ORNL/uCaspian/ip/osresearch/README.md

osresearch
==========

This HDL was originally sourced from [osresearch/up5k](https://github.com/osresearch/up5k) and modified.

divide_by_n.v: https://github.com/osresearch/up5k/blob/2eef12a9659b8fc4ebf68656198b8840f6da2e0d/util.v
pulse_stretcher.v: https://github.com/osresearch/up5k/blob/2eef12a9659b8fc4ebf68656198b8840f6da2e0d/util.v
pwm.v: https://github.com/osresearch/up5k/blob/2eef12a9659b8fc4ebf68656198b8840f6da2e0d/util.v
util.vh: https://github.com/osresearch/up5k/blob/2eef12a9659b8fc4ebf68656198b8840f6da2e0d/util.v
uart.v: https://github.com/osresearch/up5k/blob/2eef12a9659b8fc4ebf68656198b8840f6da2e0d/uart.v
