ORNL/uCaspian/CHANGELOG.md

# Changelog

All notable changes to this project will be documented in this file.

The format is based on [Keep a Changelog](https://keepachangelog.com/en/1.0.0/),
and this project adheres to a custom Development Versioning specified by Aaron Young.

A summary of Development Versioning Specification is shown below.

> Given a version number BRANCH.TAG.BUILD, increment the:
> 1. BRANCH version when you make breaking/major changes that you want to track in a separate branch.
> 2. TAG version when you make a new tag to mark a specific spot.
> 3. BUILD version when you create a new build with artifacts or bug fixes for that you want to point to.
>
> Then for your repo you have branch versions for each version. For example branches v0 and v1. Then when you create tags, say on branch v0, you would create tags v0.0.0, v0.1.0, and v0.2.0.
> CI or a manual process could add v0.0.x branches as new changes are added to a local branch. BUILD is also used when patches are applied to a tagged branch, after the patch is applied, add a new tag with BUILD + 1.
>
> `main` always points to the current major branch plus 1. `dev` is an integration branch before merging into `main`. When `dev` is merged into `main`, the TAG is updated.

## [2.0.0] - 2023-09-14

### Changed
- Restructured project to better support using uCaspian in an external project.
- Separated third party IP from ORNL uCaspian RTL.
- Updated and attempted to improve README.

### Added
- Sphinx documentation generator.
- Basic SystemVerilog testbench.
- Conda environment.
- Low power uduinolp/ucaspianlp designs with clock gating.
- Wishbone interface wrapper and testbench.
- Lint waivers.

### Removed
- Unused network files.
- Support for mimas board.

## [1.0.0] - 2023-09-09

Released an initial version of uCaspian from Parker Mitchell. This version has no breaking or major
changes from the original uCaspian source.

### Added
- Initial Code from Parker.
- A changelog.
