ORNL/uCaspian/(commit log)

2019-12-04 possible for fix output spike issues
    [ucaspian_core.sv]
2019-12-12 fix what seems to be a dendrite accumulation bug when two inputs target same idx back to back
    [dendrite.sv, neuron.sv]
2020-03-06 project set up for dev board
2020-03-16 redesign neuron, fix dendrite/neuron handshake, misc cleanup
    [dendrite.sv, dendrite_mux.sv, dev_r0.pcf, dp_ram.sv, neuron.sv]
2020-04-27 clear activity for delay; fix axon 0 special case
    [axon.sv]
2020-04-27 (axon) fix double fire & stuck fire
    [axon.sv]
2020-04-27 going to bed
2020-04-28 [axonal delay] very chicken wired, but closer?
2020-04-29 reset & clear bug fixes
    [axon.sv, dendrite.sv, dendrite_mux.sv, neuron.sv, ucaspian_core.sv]
2020-05-03 fix write after write data dependency in dendrite
    [dendrite.sv]
2020-05-07 try to fix blocking on sequential axon fires
    [axon.sv]
2020-05-11 fix saturating addition of charge in neuron
    [neuron.sv]
2020-05-11 makes the fix work properly on fpga, not just verilator
    [neuron.sv]
2020-05-11 fix flow control in fire dispatch
    [fire_dispatch.sv]
2020-05-15 A redesign of the axon
    [axon.sv]
2020-05-15 attempt to patch multi-fire bug in neuron when paired with new axon
    [neuron.sv]
2020-05-16 more attempts to fix a2a+dly tests
    [axon.sv, neuron.sv]
2020-05-17 event driven axon, synapse/dendrite speed up and fixes
    [axon.sv, dendrite_mux.sv, fire_dispatch.sv, synapse.sv]
2020-05-18 neuron flow control fix?
    [neuron.sv]
2020-05-18 is this better? tests say maybe but there are still problems with a2a + dly networks
    [axon.sv]
2020-05-18 the final fix -- now passing the initial a2a+dly tests
    [axon.sv, find_set_bit.sv]
2020-05-19 bump up the communications -- should work but there were problems the last time I did this
    [dev_r0_top.sv]
2020-05-29 make pins directory as more constraint files are added; up the dev board frequency to 30 MHz using the FPGA's PLL
2020-05-29 mimas a7 board support
2020-05-30 build flow for mimas / xilinx artix 7
2022-01-26 Added uart interface back for uCaspian.
2022-03-03 Starting to add spi uCaspian interface.
2022-03-03 Added pico project.
2022-03-04 Spi writing working.
2022-03-05 Almost working. Still has a bug
    [spi.sv, test.cpp, upduino_spi_top.sv]
2022-03-08 Finished initial SPI exporation.
    ~2.42 Mbps is the fastest working speed.
2022-03-09 Working SPI V4 design.
2022-05-25 Update README.md to include bitbucket framework repo.
2022-06-19 Successful test of SPI with uCaspian.
    - Separated out loop testing logic.
    - Added spi_top and passthrough pico program.
2022-09-20 Fix trailing comma syntax error
    Trailing commas in port declartions is not valid SystemVerilog/Verilog.
    Yosys will accept it but most others Verilator/Modelsim/Vivado will not.
    [ucaspian.sv]
2022-09-20 Fix signal declaration
    Signals must be declared before first use. Yosys will accept but others
    will not.
    [axon.sv, dendrite.sv]
2022-09-20 Update test for new framework API
2023-08-10 Rework IP integration and board specific HDL
    This commit seperates the uCaspian core HDL from external IP cores and
    top-level wrappers for specific boards. This makes integrating uCaspian
    into other designs and frameworks much easier (i.e. OpenLane, LiteX).
    This also has the added advantage of making it easier to keep track of
    what external IP is used. This change also removes the need to use
    the legacy method of sharing models by using include headers.
    The disadvantage of this approach is we have to list all the source
    files of a design. This is typically done using a modern IP integration
    framework like FuseSoC or LiteX.
    [axis_clock_converter.sv, axis_fifo.v, axis_fifo_adapter.v, axis_ft245.sv, axon.sv, dendrite.sv, dendrite_mux.sv, dev_r0.pcf]
2023-08-10 Fix bitwidth on enable signal
    [ucaspian.sv]
2023-08-10 Add flow control to ucaspianlp
2023-08-10 Remove support for mimas board
    No one has this board and maintenance is a burden. Future users can
    revive it from this commit.
2023-08-10 Remove TOP variable derived targets
    Commit 871bc71b changed how we did make targets and TOP variable doesn't work
    as expected and should be removed.
    The help message prints how to build or build and flash designs.
2023-08-10 Remove instructions for verilated ucaspian
    Building the verilated ucaspian with the framework is broken. It has circular
    dependencies and require building multiple times.
    The original README did not include instructions for build the verilated
    ucaspian, so I removing the instructions I added.
